ivanifchen/bigger-bio-egg-dispenser/docs/img/seam.png

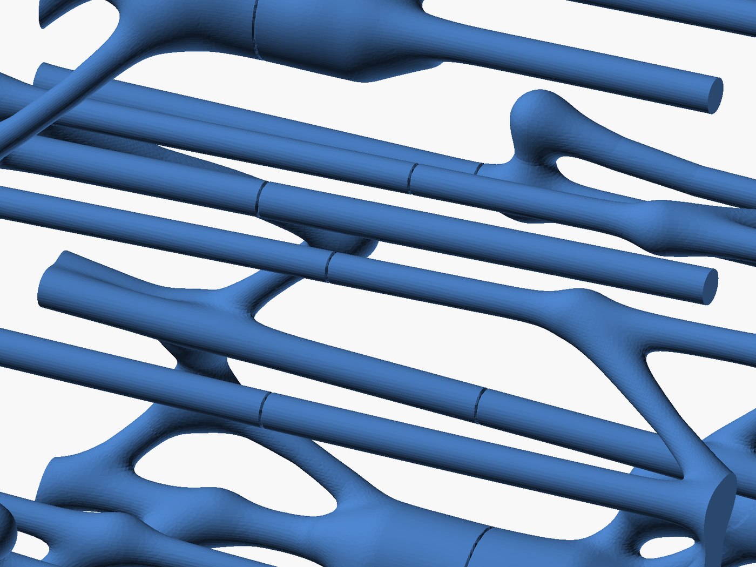
docs/img/seam.png
