ivanifchen/bigger-bio-egg-dispenser/docs/img/coupon.png

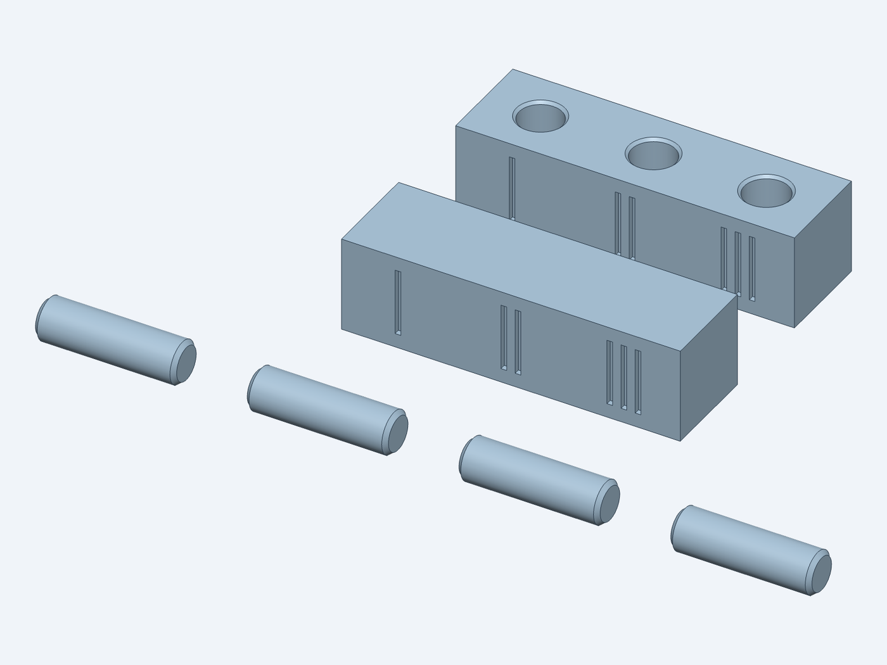
docs/img/coupon.png
