ivanifchen/bigger-bio-egg-dispenser/docs/img/halves.png

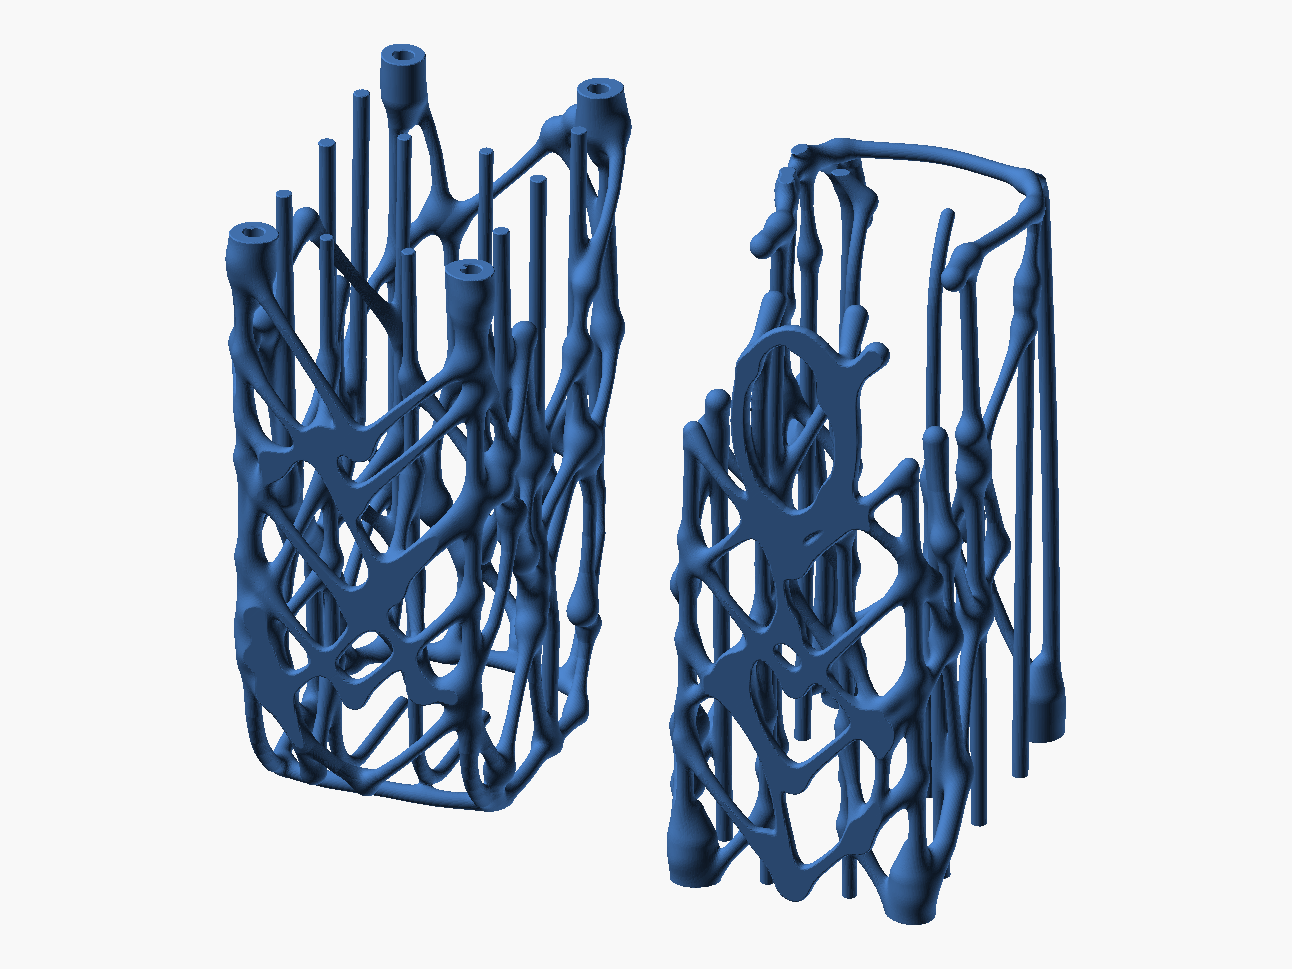
docs/img/halves.png
