ivanifchen/bigger-bio-egg-dispenser/docs/img/hero.png

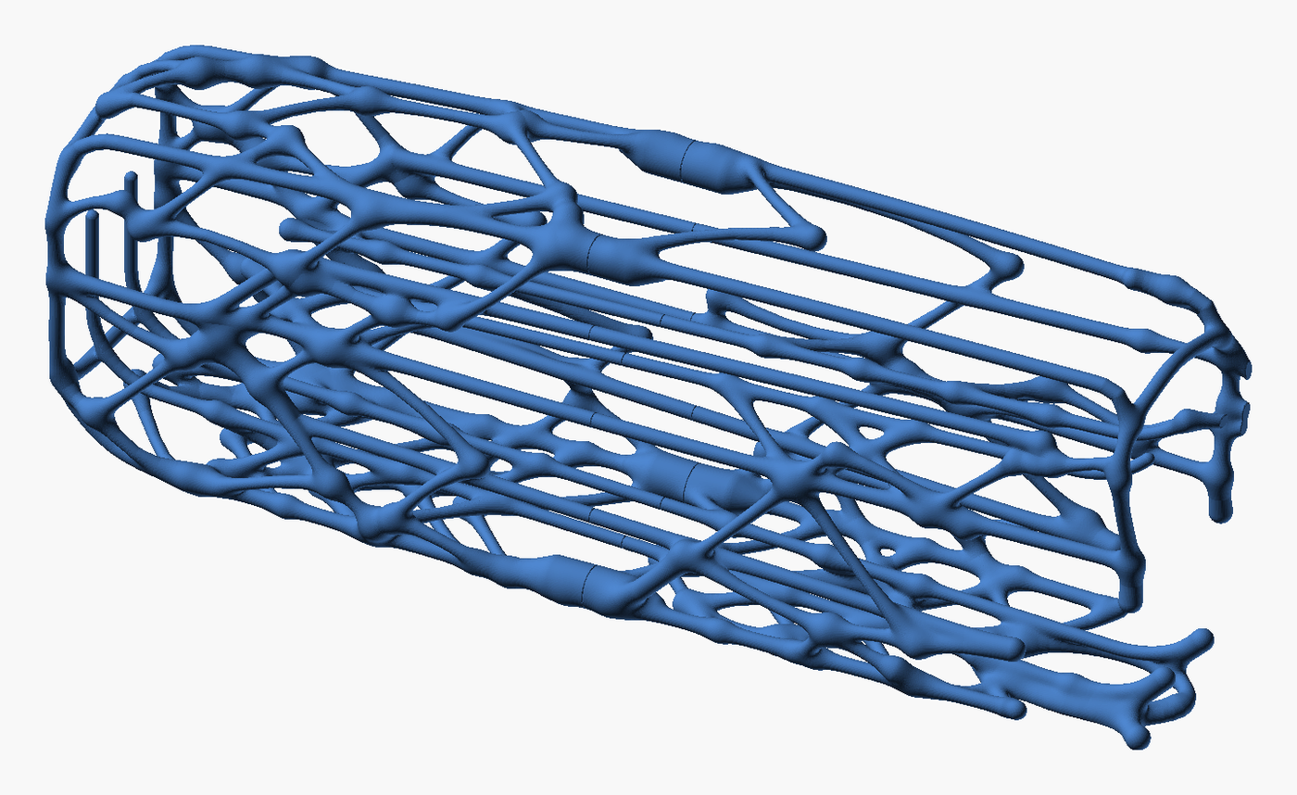
docs/img/hero.png
