ivanifchen/bigger-bio-egg-dispenser/docs/img/levels.png

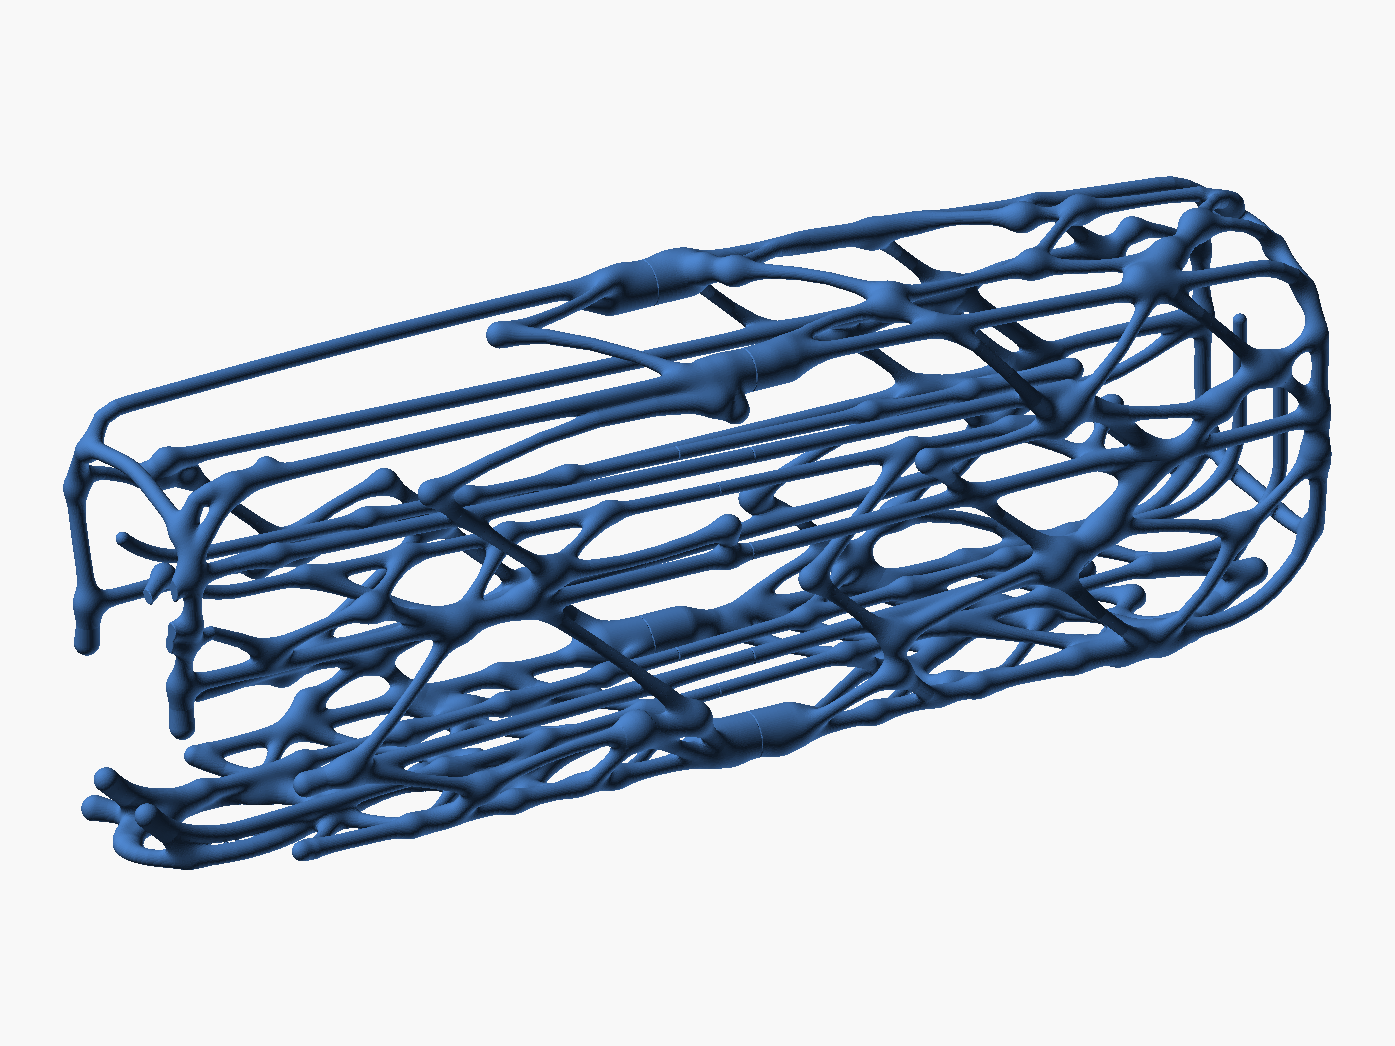
docs/img/levels.png
