ivanifchen/bigger-bio-egg-dispenser/docs/egg_dispenser_front_plate.3mf

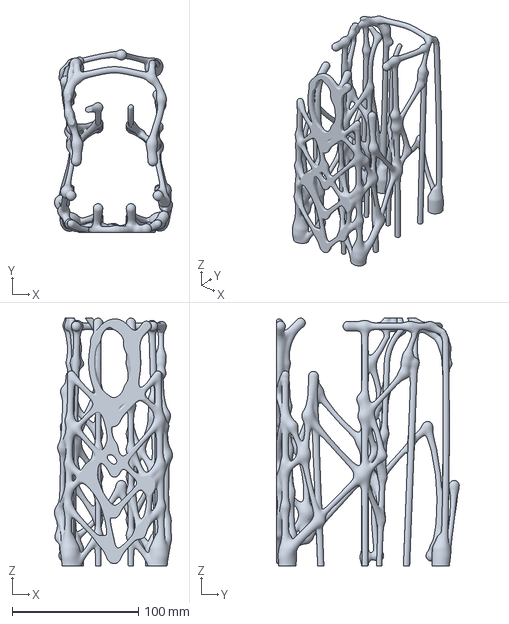
[picture p6: CAD file, 2026-11-08]
docs/egg_dispenser_front_plate.3mf
93.6 x 144.7 x 196.5 mm
