ivanifchen/bigger-bio-egg-dispenser/docs/egg_dispenser_back_plate.3mf

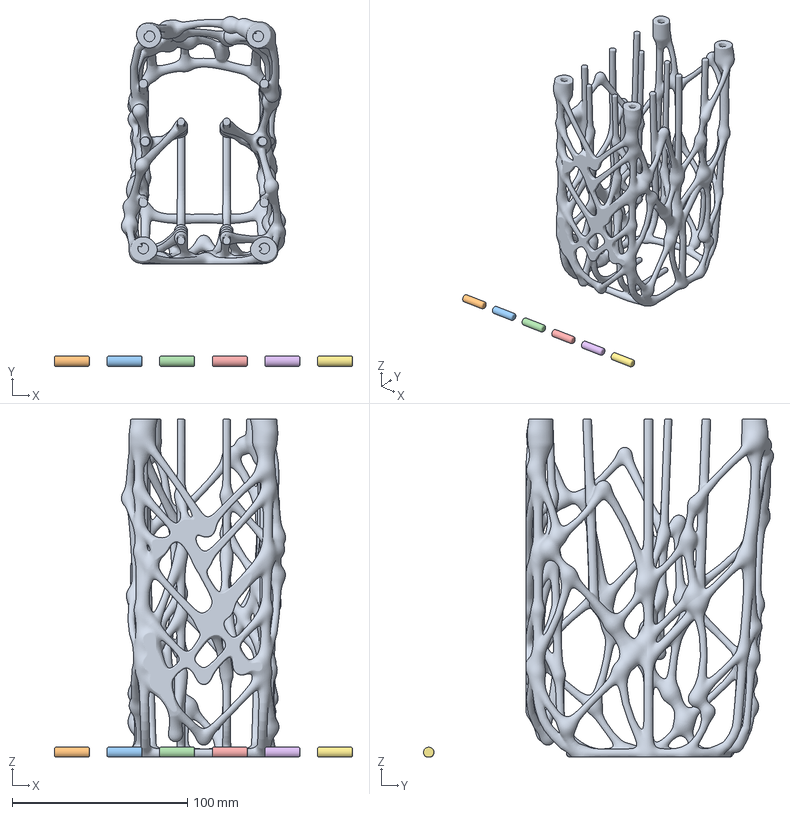
[picture p7: CAD file, 2026-11-08]
docs/egg_dispenser_back_plate.3mf
170.0 x 199.6 x 192.5 mm
back_half.stl
pin_1.stl
pin_2.stl
pin_3.stl
pin_4.stl
pin_5.stl
pin_6.stl
