ivanifchen/bigger-bio-egg-dispenser/docs/egg_dispenser_fit_coupon_plate.3mf

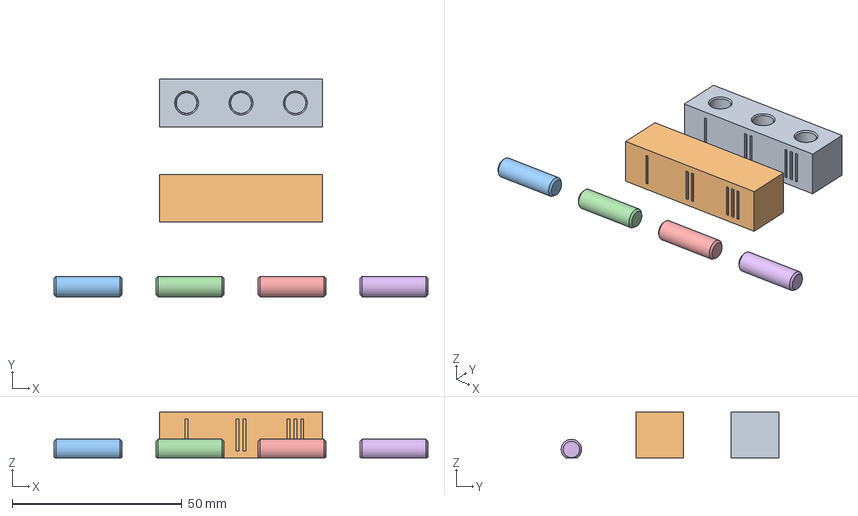
[picture p8: CAD file, 2026-11-08]
docs/egg_dispenser_fit_coupon_plate.3mf
110.0 x 64.0 x 13.5 mm
block_holes_up.stl
block_holes_on_bed.stl
pin_1.stl
pin_2.stl
pin_3.stl
pin_4.stl
