ivanifchen/bigger-bio-egg-dispenser/(commit log)

2026-11-08 Bigger bio egg dispenser v1: Grown seed 3
    A 16-egg, 389 mm remix of pymata's Bio Egg Dispenser for a 16 in fridge
    shelf, generated from scratch in the Original's style (wrapped Voronoi
    Lattice, webbed bone-shaped Struts, two-lobed cross-section), printed as two
    halves joined at 14 Contacts by 4 press-fit Pins.
    Print jobs in exports/ (Fit coupon first), archived in exports/archive/v1.
    The Original's file stays in reference/, out of git (license).
    [egg_dispenser_back_plate.3mf, egg_dispenser_fit_coupon_plate.3mf, egg_dispenser_front_plate.3mf]
2026-11-09 Publish the GitHub Pages site
    docs/index.html with renders of the final seed-3 cage in docs/img, the three
    print plate 3MFs for download, and the lattice explainer. README points to the
    page. Adds the untracked source for the Grow/Mini/SubD prototypes.
    [egg_dispenser_back_plate.3mf, egg_dispenser_fit_coupon_plate.3mf, egg_dispenser_front_plate.3mf]
